U-G-Chan/two-wheeled-balance-car/manual/代码工程构建.pdf

# 代码工程构建

## 1 在工程目录下创建目录 ./code

## 2 选择MCU

3 设置芯片引脚

3.1 设置调试信息输出引脚（连接TTL）

3.3 设置陀螺仪模块专用引脚

3.4 设置超声波模块专用引脚

3.5 设置红外避障模块专用引脚

3.6 设置电机控制模块专用引脚

## 3.7 设置SW-Debug引脚

3.8 设置外部晶振时钟引脚

3.9 设置LED信号灯引脚

4 设置时钟树

5 工程设置

6 生成工程代码

# 1 在工程目录下创建目录 ./code

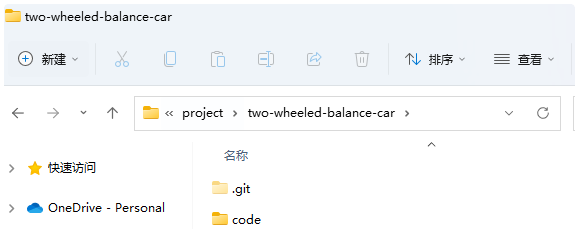
[picture p7: figure]

# 2 选择MCU

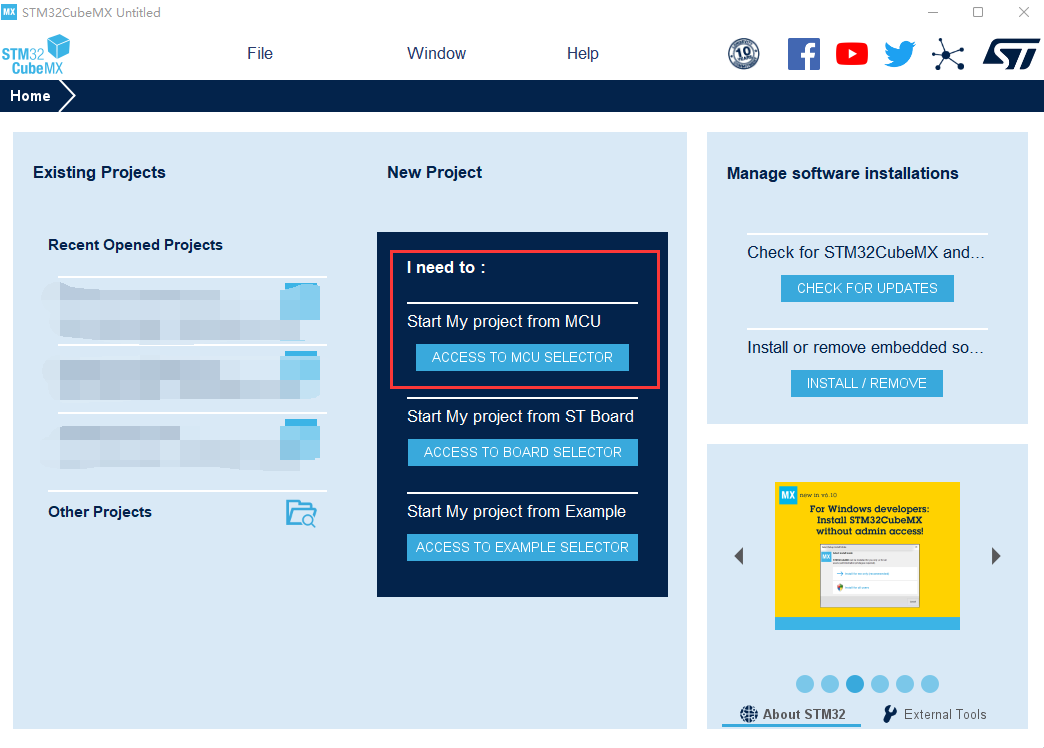
[picture p8: figure]

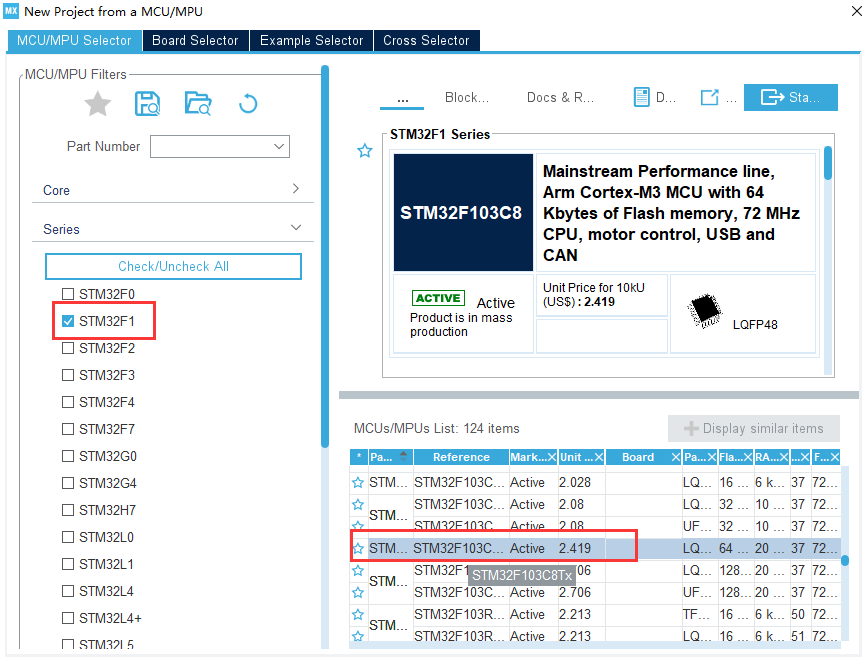
[picture p9: figure]

# 3 设置芯片引脚

## 3.1 设置调试信息输出引脚（连接TTL）

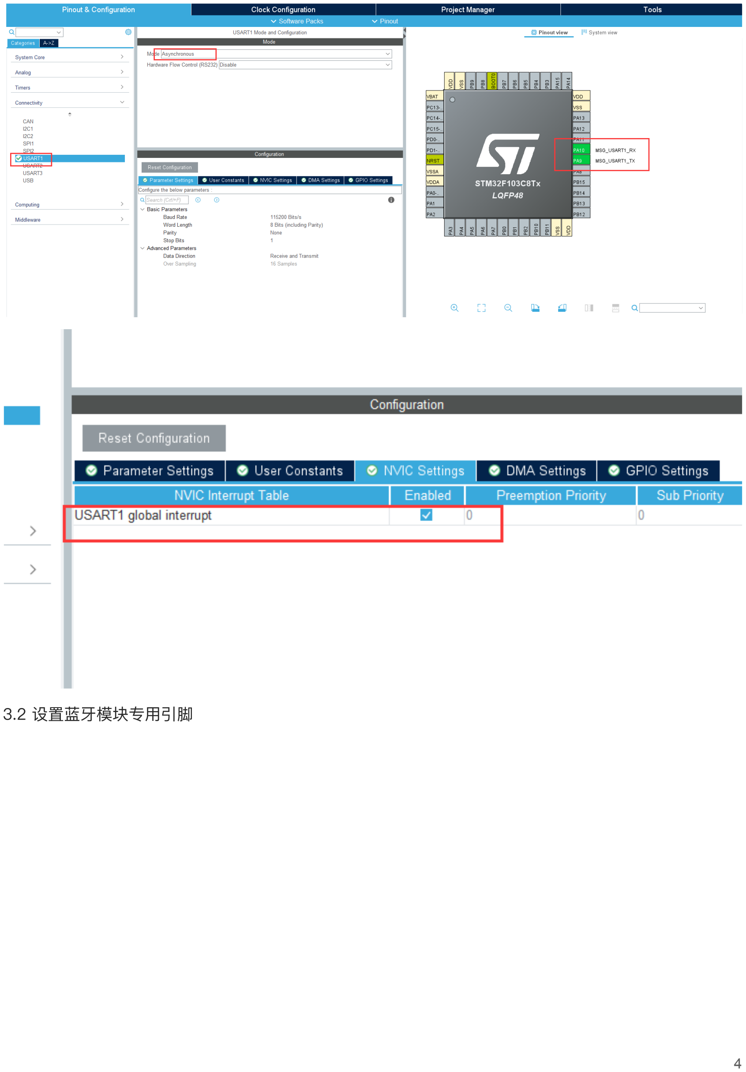
[picture p10: page 4]

3.2 设置蓝牙模块专用引脚

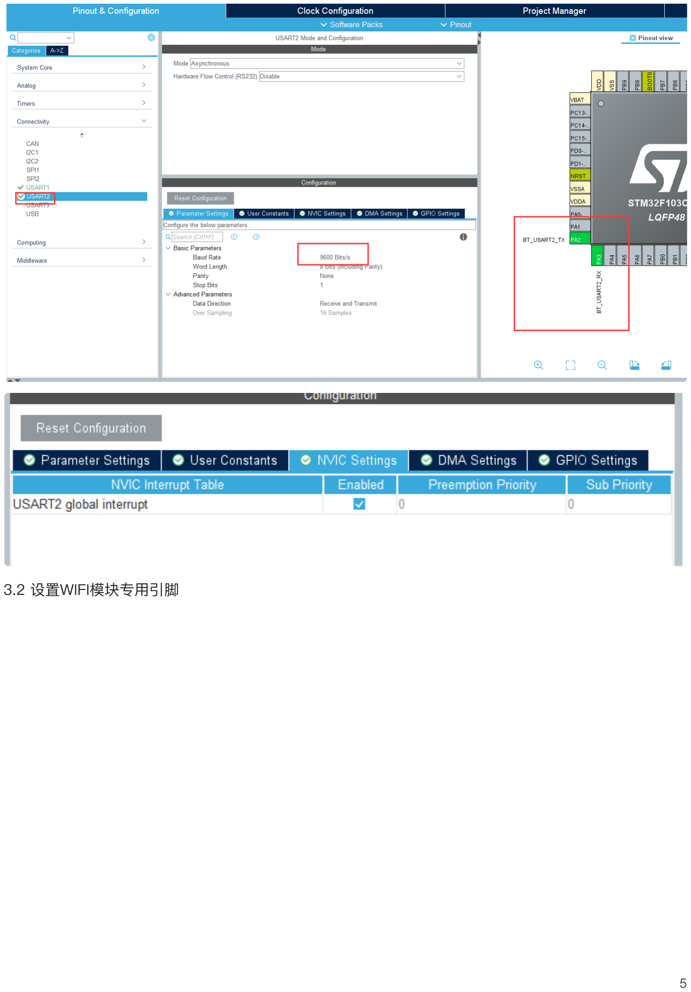
[picture p11: page 5]

3.2 设置WIFI模块专用引脚

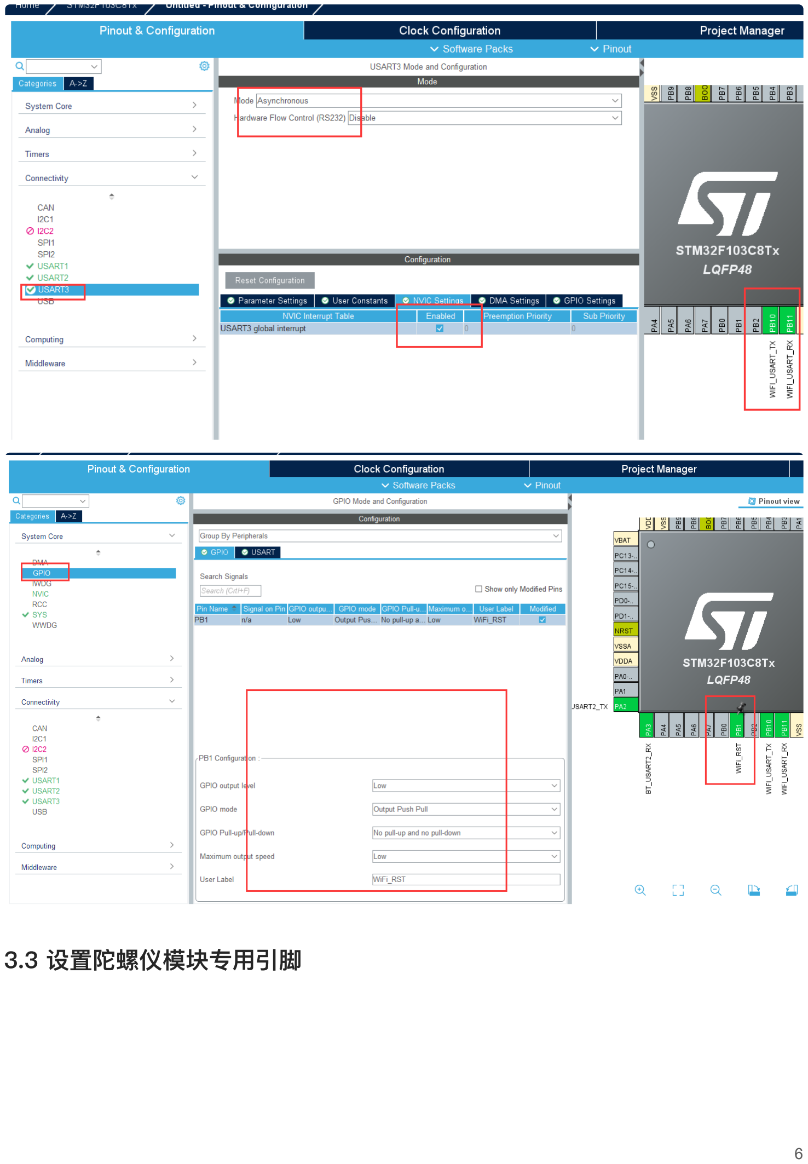
[picture p12: page 6]

## 3.3 设置陀螺仪模块专用引脚

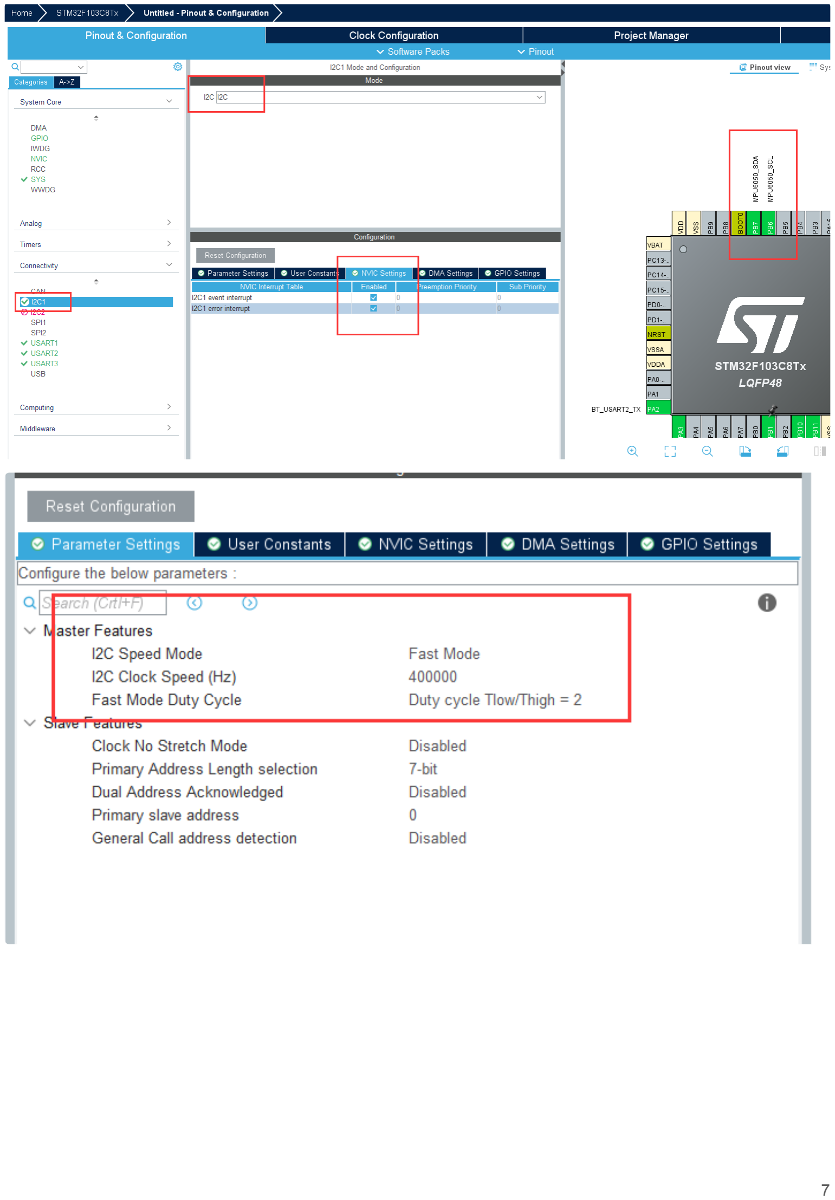
[picture p13: page 7]
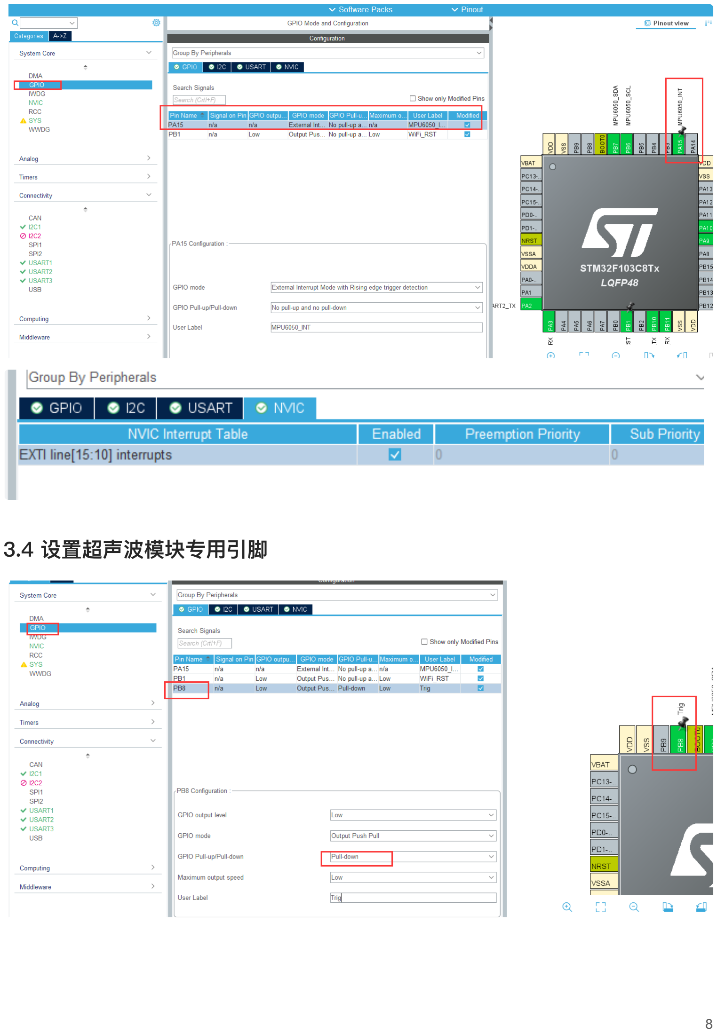
[picture p14: page 8]

## 3.4 设置超声波模块专用引脚

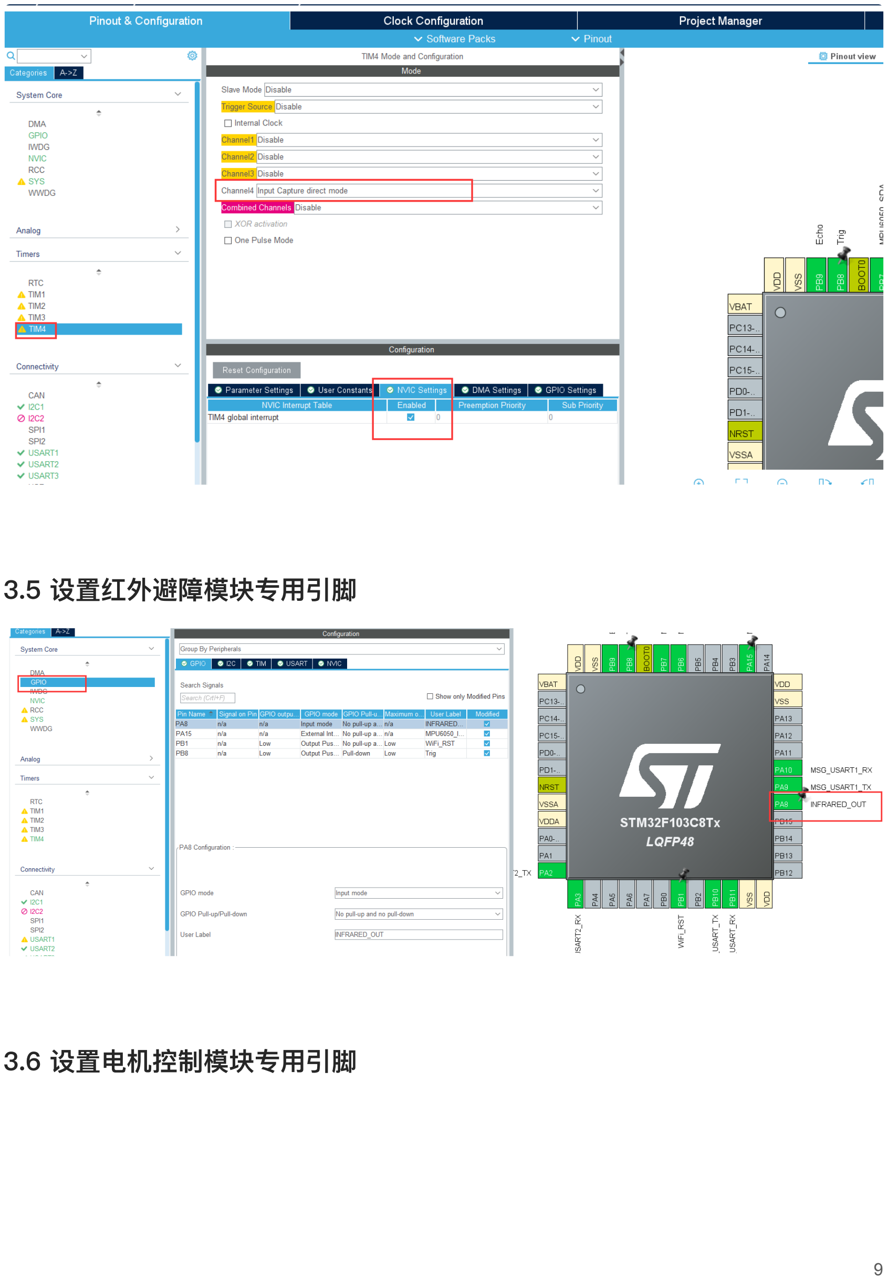
[picture p15: page 9]

## 3.5 设置红外避障模块专用引脚

## 3.6 设置电机控制模块专用引脚

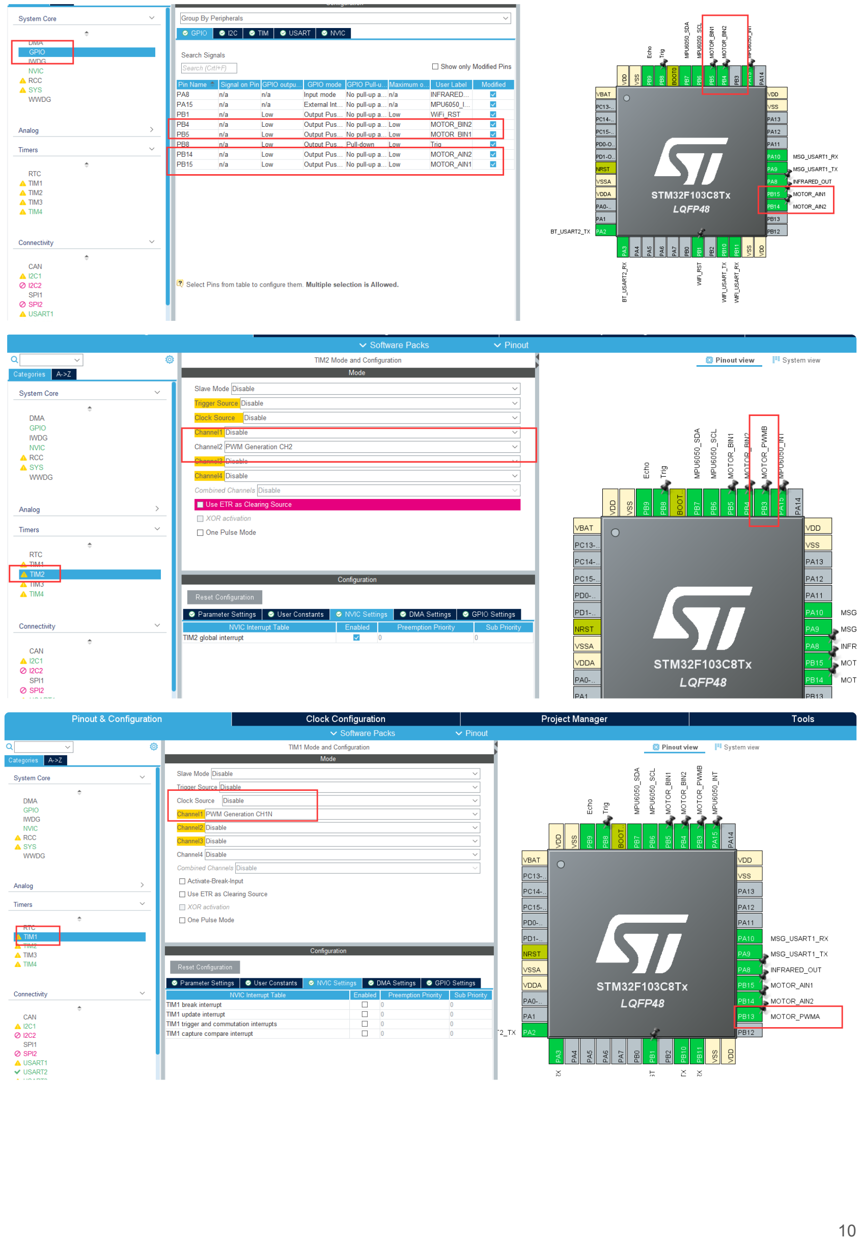
[picture p16: page 10]
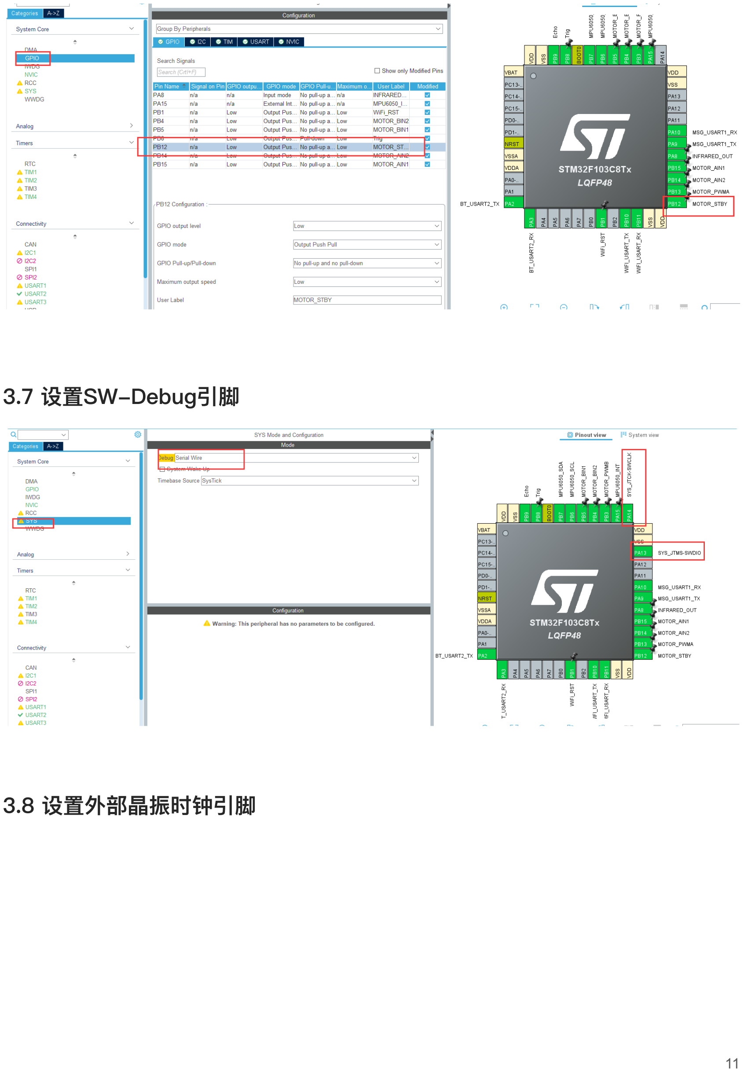
[picture p17: page 11]

## 3.7 设置SW-Debug引脚

## 3.8 设置外部晶振时钟引脚

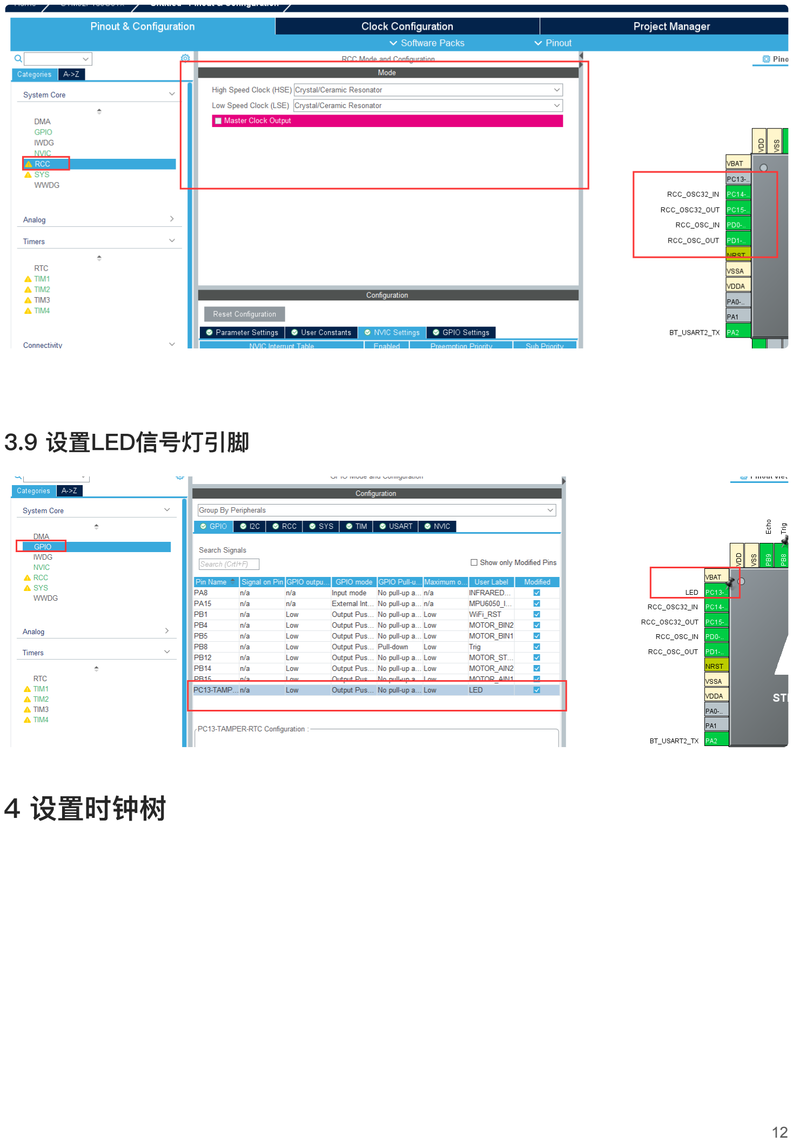
[picture p18: page 12]

## 3.9 设置LED信号灯引脚

# 4 设置时钟树

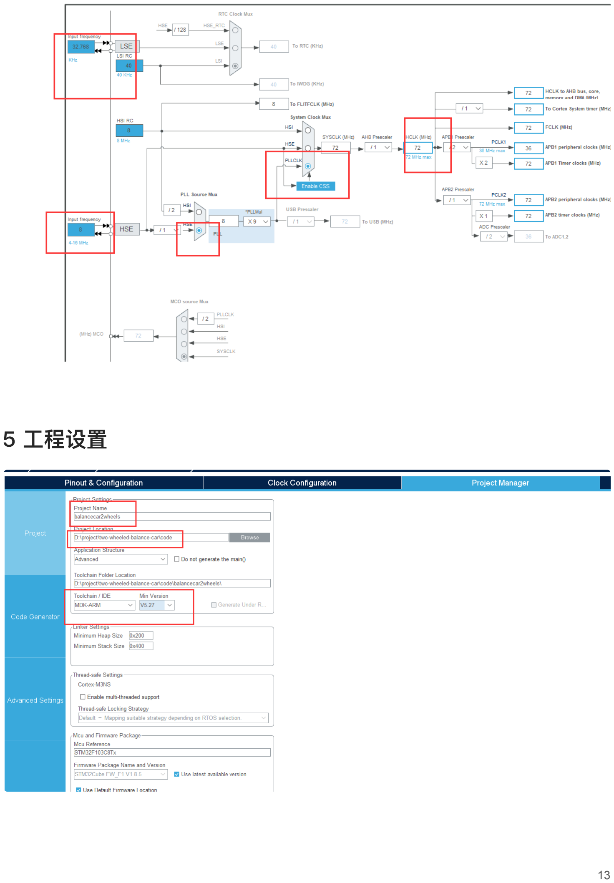
[picture p19: page 13]

# 5 工程设置

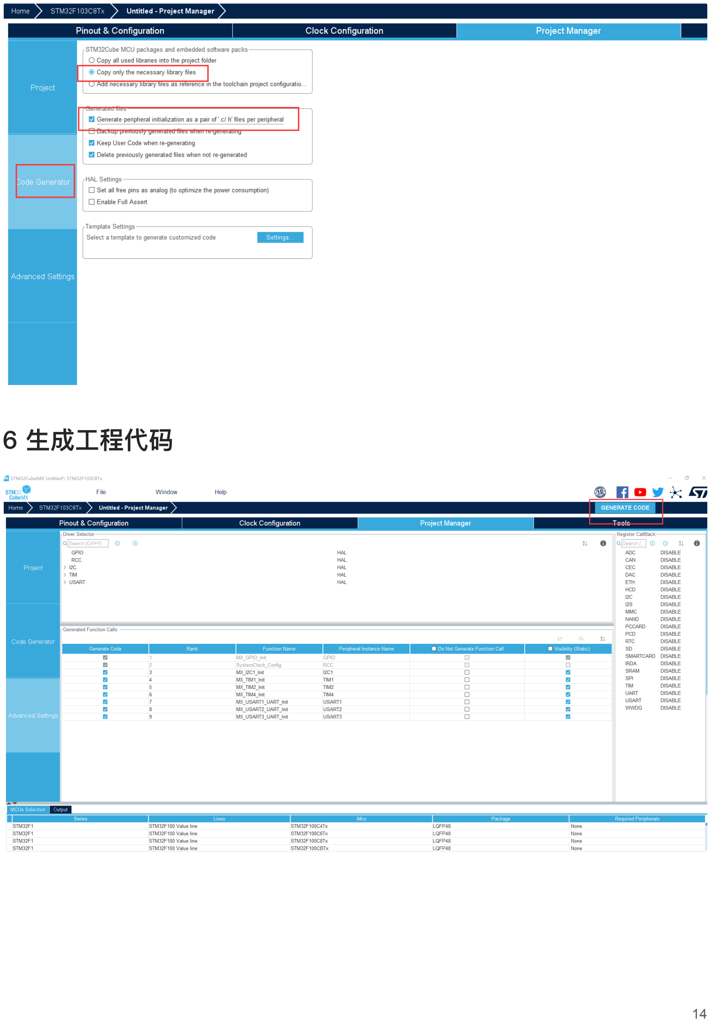
[picture p20: page 14]

# 6 生成工程代码
