U-G-Chan/two-wheeled-balance-car/PCB/PCB_底层.pdf

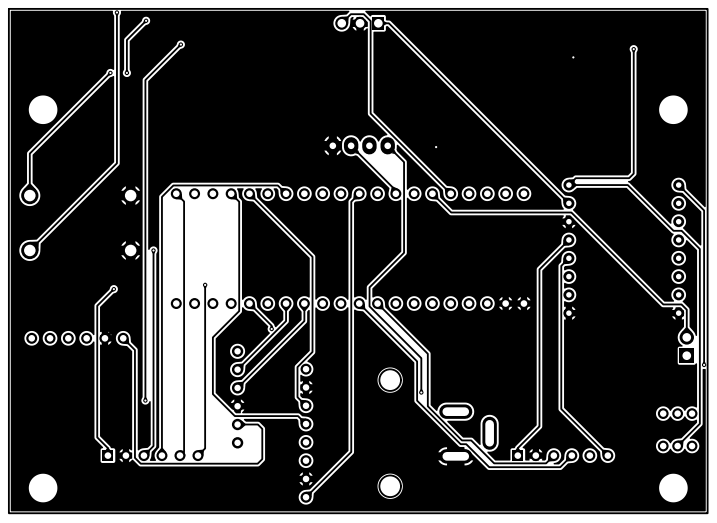
[picture p21: page 1]
