U-G-Chan/two-wheeled-balance-car/PCB/PCB_顶层.pdf

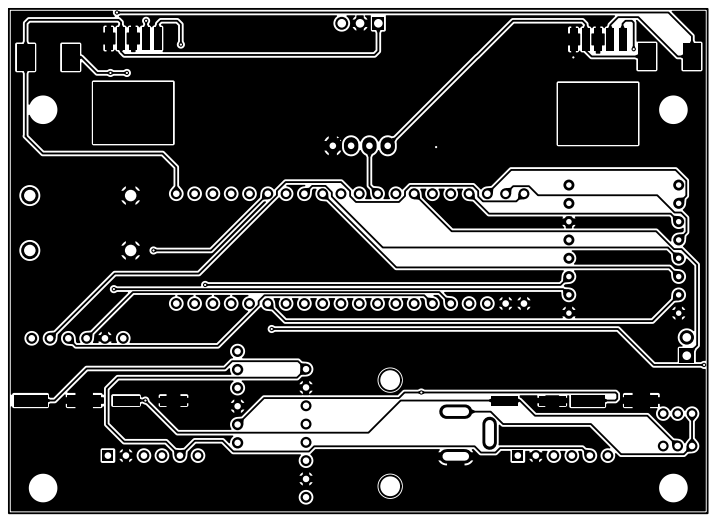
[picture p22: page 1]
