U-G-Chan/two-wheeled-balance-car/code/balancecar2wheels/Core/Src/main.c

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
/* Includes ------------------------------------------------------------------*/
#include "main.h"
#include "i2c.h"
#include "tim.h"
#include "usart.h"
#include "gpio.h"

/* USER CODE BEGIN Includes */
#include "stdio.h"
#include "IIC.h"
#include "car_mpu6050.h"

#include "motor.h"
#include "motor_encoder.h"
#include "control.h"

#include "bluetooth.h"
/* USER CODE END Includes */


/* USER CODE BEGIN PV */
uint8_t MPU6050_Update_Flag;
int MOTOR_ENCODER_A,MOTOR_ENCODER_B;
int Balance_Pwm,Velocity_Pwm,Turn_Pwm;

uint8_t mpu_init_flag = -1;

uint8_t rx_data = 0;
/* USER CODE END PV */

void SystemClock_Config(void);
/**
  * @brief  The application entry point.
  * @retval int
  */
int main(void)
{
  /* MCU Configuration--------------------------------------------------------*/

  /* Reset of all peripherals, Initializes the Flash interface and the Systick. */
  HAL_Init();

  /* Configure the system clock */
  SystemClock_Config();

  /* Initialize all configured peripherals */
  MX_GPIO_Init();
  MX_I2C1_Init();
  MX_TIM1_Init();
  MX_TIM2_Init();
  MX_TIM4_Init();
  MX_USART1_UART_Init();
  MX_USART2_UART_Init();
  MX_USART3_UART_Init();
  MX_TIM3_Init();
  /* USER CODE BEGIN 2 */
	HAL_TIM_Base_Start_IT(&htim1);
	HAL_TIM_Base_Start_IT(&htim2);
	HAL_TIM_Encoder_Start(&htim3,TIM_CHANNEL_1 | TIM_CHANNEL_2); 
	HAL_TIM_Encoder_Start(&htim4,TIM_CHANNEL_1 | TIM_CHANNEL_2);
	
	HAL_UART_Receive_IT(&HUART_BLUETOOTH, &rx_data, 1);

	motor_init();
	mpu_init_flag = mpu6050_init();
	if(mpu_init_flag == 0){
		printf("mpu init success.\r\n");
	}else{
		printf("mpu init fail.\r\n");
	}
	
	float forward_angle = -1;
	short forward_gyr = -1;
	
  /* USER CODE END 2 */

  /* Infinite loop */
  /* USER CODE BEGIN WHILE */
  while (1)
  {
    /* USER CODE END WHILE */

    /* USER CODE BEGIN 3 */
		HAL_Delay(100);
		
  }
  /* USER CODE END 3 */
}

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
/* USER CODE BEGIN 4 */
void HAL_TIM_PeriodElapsedCallback(TIM_HandleTypeDef *htim) {
  if (htim->Instance == TIM1) {
		if(mpu_init_flag == HAL_OK){		
			control_pwm();
		}
  }      
}

void HAL_UART_RxCpltCallback(UART_HandleTypeDef *huart)  {
	
	 if (huart->Instance == USART2)  // 当前接收中断UART2
    {
			//printf("%c\r\n",rx_data);
			bluetooth_fm_buf_it(&rx_data);
			
    }
}


/* USER CODE END 4 */
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
