U-G-Chan/two-wheeled-balance-car/code/balancecar2wheels/balancecar2wheels.ioc

Mcu.UserName=STM32F103C8Tx
PA0-WKUP.GPIO_Label=MOTOR_PWMA
PA0-WKUP.Signal=S_TIM2_CH1_ETR
PA1.GPIO_Label=MOTOR_PWMB
PA1.Signal=S_TIM2_CH2
PA10.GPIO_Label=MSG_USART1_RX
PA10.Signal=USART1_RX
PA11.GPIO_Label=Echo
PA11.Signal=S_TIM1_CH4
PA12.GPIO_Label=Trig
PA12.Signal=GPIO_Output
PA13.Signal=SYS_JTMS-SWDIO
PA14.Signal=SYS_JTCK-SWCLK
PA15.GPIO_Label=MPU6050_INT
PA15.Signal=GPXTI15
PA2.GPIO_Label=BT_USART2_TX
PA2.Signal=USART2_TX
PA3.GPIO_Label=BT_USART2_RX
PA3.Signal=USART2_RX
PA6.GPIO_Label=MOTOR_A_EA
PA6.Signal=S_TIM3_CH1
PA7.GPIO_Label=MOTOR_A_EB
PA7.Signal=S_TIM3_CH2
PA8.GPIO_Label=INFRARED_OUT
PA8.Signal=GPIO_Input
PA9.GPIO_Label=MSG_USART1_TX
PA9.Signal=USART1_TX
PB10.GPIO_Label=WIFI_USART3_TX
PB10.Signal=USART3_TX
PB11.GPIO_Label=WIFI_USART3_RX
PB11.Signal=USART3_RX
PB12.GPIO_Label=WIFI_RST
PB12.Signal=GPIO_Output
PB13.GPIO_Label=MOTOR_STBY
PB13.Signal=GPIO_Output
PB14.GPIO_Label=MOTOR_AIN2
PB14.Signal=GPIO_Output
PB15.GPIO_Label=MOTOR_AIN1
PB15.Signal=GPIO_Output
PB4.GPIO_Label=MOTOR_BIN2
PB4.Signal=GPIO_Output
PB5.GPIO_Label=MOTOR_BIN1
PB5.Signal=GPIO_Output
PB6.GPIO_Label=MOTOR_B_EA
PB6.Signal=S_TIM4_CH1
PB7.GPIO_Label=MOTOR_B_EB
PB7.Signal=S_TIM4_CH2
PB8.GPIO_Label=MPU6050_SCL
PB8.Signal=I2C1_SCL
PB9.GPIO_Label=MPU6050_SDA
PB9.Signal=I2C1_SDA
PC13-TAMPER-RTC.GPIO_Label=LED
PC13-TAMPER-RTC.Signal=GPIO_Output
PC14-OSC32_IN.Signal=RCC_OSC32_IN
PC15-OSC32_OUT.Signal=RCC_OSC32_OUT
PD0-OSC_IN.Signal=RCC_OSC_IN
PD1-OSC_OUT.Signal=RCC_OSC_OUT
