U-G-Chan/two-wheeled-balance-car/(commit log)

2023-12-19 代码工程构建步骤
2023-12-21 添加motor组件，实现直流电机速度开环控制
2023-12-21 添加mpu6050组件
2023-12-21 添加信息输出定义
2023-12-22 添加motor_encoder组件，更新原理图和引脚设置，实现直流电机速度闭环控制
2024-01-01 mpu6050debug保存进度
2024-01-01 实现mpu6050-dmp算法采集姿态pitch roll yaw
2024-01-01 实现小车站立平衡控制
2024-01-05 phoneapp:home。可以将信息输出到面板，可以实现模式控制和方向控制
2024-01-06 phoneapp:dashboard开发前
2024-01-06 phoneapp:dashboard实现扫描并展示已配对蓝牙设备功能
2024-01-06 phoneapp:修改TerminalFragment前
2024-01-06 phoneapp-dashboard(实现手机APP向蓝牙发送信息)
2024-01-06 phoneapp-dashboard(实现蓝牙向手机APP发送信息)
2024-01-09 phoneapp-dashboard(解决切换页面时蓝服务销毁问题)
2024-01-09 phoneapp-dashboard(添加PID参数设置面板)
2024-01-10 phoneapp-notification(设置基本页面)
2024-01-10 phoneapp-dashboard(实现发送PID更新数据包功能)
2024-01-10 phoneapp-home(清除无效代码)
2024-01-10 phoneapp-home(简化按键相应函数)
2024-01-10 phoneapp-home(解决终端信息因为切换页面而无法显示问题)
2024-01-10 phoneapp-notification(完成监听功能demo)
2024-01-10 phoneapp-notification(完成信息监听功能)
2024-01-11 phoneapp-dashboard(实现平衡车接收蓝牙信息并响应)
2024-01-11 实现平衡车接收蓝牙信息帧
2025-03-04 PCB设计原理图与力创EDA工程文件
2025-03-04 设计报告
2025-03-04 PCB设计原理图与EDA工程文件
