U-G-Chan/two-wheeled-balance-car/(notices)

Notices in the files:
code/balancecar2wheels/Core/Inc/main.h:
© Copyright (c) 2023 STMicroelectronics.
All rights reserved.
